TH4R4V3N1324/hexapod-ros2/foxglove_panel/README.md

# Hexapod Foxglove panel

A Foxglove panel for the hexapod, through `foxglove_bridge`:

- **Body**: roll and pitch from `/imu/data`, with an attitude indicator.
- **Feet**: the six feet in their layout, filled when the foot's upward force on
  `/foot_force/legN` is above gait_controller's `contact_force_on`. gait_controller
  publishes these at `foot_force_rate` (20 Hz): at the joint state rate the six
  topics were 600 messages a second, which made Foxglove on the Steam Deck lag.
- **Power**: voltage, current and charge from `/power/left` and `/power/right`, and
  behaviour_manager's battery status from `/diagnostics`. When the battery is low,
  critical (the robot sits down) or a board stops reporting, a banner at the top of
  the panel says so.
- **Mode and gait**: from `get_capabilities`, changed with `set_mode` and `set_gait`.
  Height is sent with `set_height` when the slider is let go (8–15 cm). **Sit down** /
  **Stand up** calls `sit`, and follows `/seated` when behaviour_manager sits the
  robot down on a flat battery.
- **Features**: gait_controller's switchable features. Each shows the node's
  parameter and changes it with its `set_<feature>` service.

## Build and install

Needs Node.js 18 or later.

```sh
npm install
npm run package        # writes raven.hexapod-panel-<version>.foxe
```

Install the `.foxe` by dragging it onto the Foxglove window (or Settings →
Extensions), then add the **Hexapod** panel to a layout. `npm run local-install`
installs it into the Foxglove app on the same machine instead.
