TH4R4V3N1324/hexapod-ros2/steamdeck/images/blink0.png

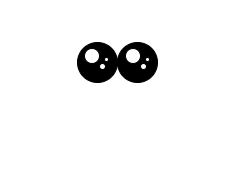
steamdeck/images/blink0.png
