TH4R4V3N1324/hexapod-ros2/hexapod_ws/src/hexapod_description/meshes/body.stl

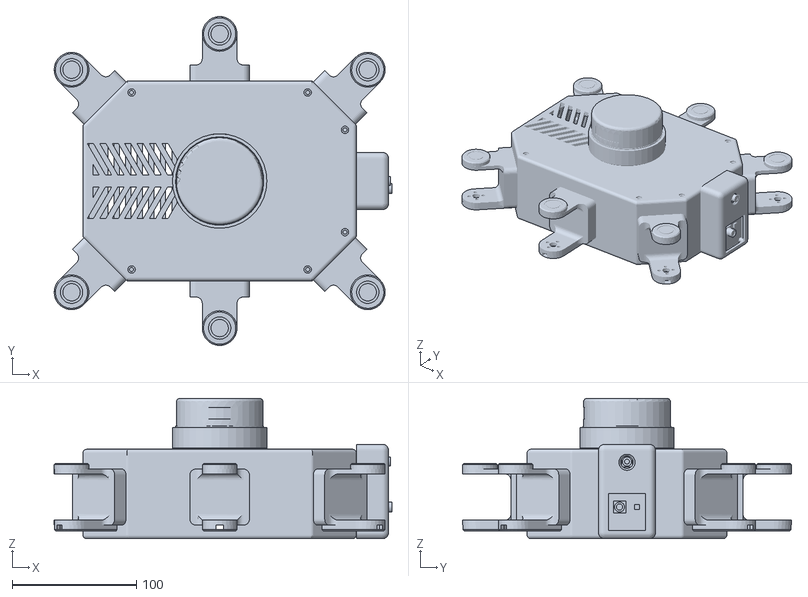
[picture p2: CAD file, 2026-10-23]
hexapod_ws/src/hexapod_description/meshes/body.stl
271.6 x 264.7 x 113.0
