TH4R4V3N1324/hexapod-ros2/hexapod_ws/src/hexapod_description/meshes/femur_right.stl

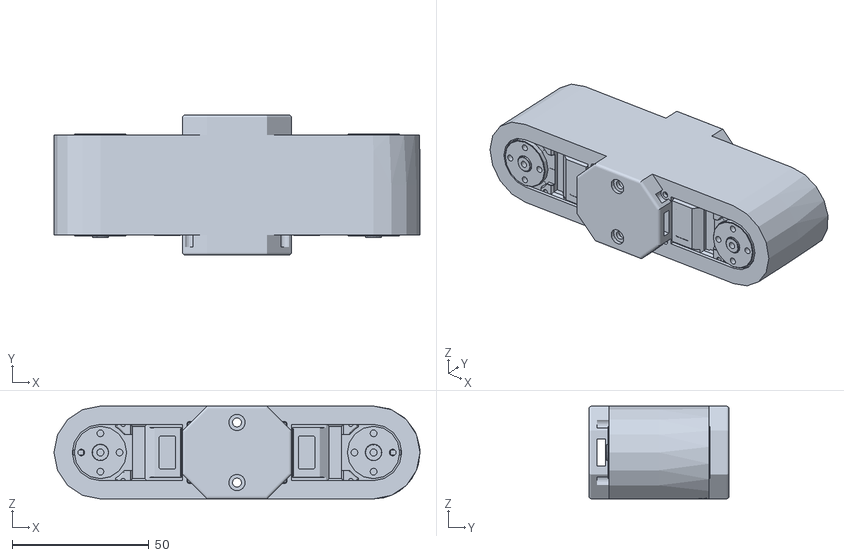
[picture p3: CAD file, 2026-10-19]
hexapod_ws/src/hexapod_description/meshes/femur_right.stl
134.0 x 51.3 x 34.0
