TH4R4V3N1324/hexapod-ros2/hexapod_ws/src/hexapod_gait_controller/test/golden/gait_trace.csv

tick | section | published | leg1_coxa_joint | leg1_femur_joint | leg1_tibia_joint | leg2_coxa_joint | leg2_femur_joint | leg2_tibia_joint | leg3_coxa_joint | leg3_femur_joint | leg3_tibia_joint | leg4_coxa_joint | leg4_femur_joint | leg4_tibia_joint | leg5_coxa_joint | leg5_femur_joint | leg5_tibia_joint | leg6_coxa_joint | leg6_femur_joint | leg6_tibia_joint
0 | startup | 1 | 0 | -0.0579429041008 | 0.0892445608168 | 0 | -0.0579429041008 | 0.0892445608168 | 0 | -0.0579429041008 | 0.0892445608168 | 0 | -0.0579429041008 | 0.0892445608168 | 0 | -0.0579429041008 | 0.0892445608168 | 0 | -0.0579429041008 | 0.0892445608168
1 | startup | 1 | 7.9679209641e-17 | -0.0923363707265 | 0.142341568806 | 0 | -0.0923363707265 | 0.142341568806 | 7.9679209641e-17 | -0.0923363707265 | 0.142341568806 | -7.9679209641e-17 | -0.0923363707265 | 0.142341568806 | 0 | -0.0923363707265 | 0.142341568806 | -7.9679209641e-17 | -0.0923363707265 | 0.142341568806
2 | startup | 1 | 0 | -0.122559213489 | 0.189061395155 | 0 | -0.122559213489 | 0.189061395155 | 0 | -0.122559213489 | 0.189061395155 | 0 | -0.122559213489 | 0.189061395155 | 0 | -0.122559213489 | 0.189061395155 | 0 | -0.122559213489 | 0.189061395155
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
