TH4R4V3N1324/hexapod-ros2/hexapod_ws/src/hexapod_description/urdf/hexapod.urdf.xacro

<robot xmlns:xacro="http://ros.org/wiki/xacro" name="hexapod">

  <xacro:arg name="controllers_file" default=""/>
  <!-- Waveshare ST3215 at 12 V: 2.94 N·m stall torque, 0.222 s/60° no-load speed -->
  <xacro:property name="servo_effort" value="2.94"/>
  <xacro:property name="servo_velocity" value="4.7"/>
  <!-- Femur range from the CAD meshes: raising it hits the coxa bracket at -100 deg, lowering it
       with the knee folded puts the tibia into the body at +86 deg. Both ~10 deg inside contact. -->
  <xacro:property name="femur_lower" value="-1.6"/>
  <xacro:property name="femur_upper" value="1.4"/>
  <!-- Tibia range from the lighter V6.1 tibia (Hexapod_V6_1_posed.step). 0 is the tibia straight out
       in line with the femur (the knee-to-foot line), positive folds it down, so the knee is at 90 deg
       at +90. Folding, the tibia meets the femur's shell at +157 deg; straightening, at -59 deg (both
       within a degree wherever the shank's piston sits). Folding keeps ~6 deg in hand and straightening
       ~14, as before. The gait controller lowers any swing that would fold further (limitSwingLift). -->
  <xacro:property name="tibia_lower" value="-0.78"/>
  <xacro:property name="tibia_upper" value="2.63"/>
  <!-- ros2_control hardware: gazebo, mock or st3215 (see hexapod.ros2_control.xacro) -->
  <xacro:arg name="hardware" default="mock"/>
  <xacro:arg name="serial_port" default="/dev/ttyAMA0"/>

  <!-- ================= CONSTANTS ================= -->
  <!-- Measured from Hexapod_V6.1 (joint caps and feet). base_link sits on the hip plane, the
       height of the femur axes, 33.85 mm above the bottom of the body. -->
  <xacro:property name="coxa_length" value="0.063"/>    <!-- coxa axis to femur axis, level -->
  <xacro:property name="femur_length" value="0.1"/>     <!-- femur axis to knee axis -->
  <!-- Knee axis to the bottom of the foot, along the straight line through the curved tibia
       (171.95 mm to the foot ball's centre, plus its 14 mm radius) -->
  <xacro:property name="tibia_length" value="0.186"/>
  <!-- Coxa axes on the slimmer V6.1 body (220 x 161 mm). Every leg mount's coxa axis is 37.96 mm
       out from the body face it sits on: the middle legs' faces are 80.4 mm from the centre, and
       the corner legs sit in the middle of 45 degree chamfers whose centres are at (92.32, 62.68). -->
  <xacro:property name="middle_leg_y" value="0.11836"/>
  <xacro:property name="corner_leg_x" value="0.11916"/>
  <xacro:property name="corner_leg_y" value="0.08952"/>
  <!-- Meshes are exported from the STEP in mm, already in each link's frame. The tibia's shank sits
       where tibia_length assumes, its foot ball 171.9 mm from the knee. -->
  <xacro:property name="mesh_scale" value="0.001 0.001 0.001"/>

  <!-- Masses and inertias from the CAD (scripts/mass_properties.py) -->
  <xacro:include filename="$(find hexapod_description)/urdf/hexapod.inertials.xacro"/>

  <!-- ================= MATERIALS ================= -->
  <material name="black"><color rgba="0.1 0.1 0.1 1"/></material>
  <material name="red"><color rgba="1 0 0 1"/></material>
  <material name="green"><color rgba="0 1 0 1"/></material>
  <material name="blue"><color rgba="0 0 1 1"/></material>
  <material name="yellow"><color rgba="1 1 0 1"/></material>
  <material name="cyan"><color rgba="0 1 1 1"/></material>
  <material name="magenta"><color rgba="1 0 1 1"/></material>

  <!-- ================= BASE ================= -->
  <link name="base_link">
    <visual>
      <geometry>
        <mesh filename="package://hexapod_description/meshes/body.stl" scale="${mesh_scale}"/>
      </geometry>
      <material name="black"/>
    </visual>
    <collision>
      <geometry>
        <mesh filename="package://hexapod_description/meshes/body.stl" scale="${mesh_scale}"/>
      </geometry>
    </collision>
    <xacro:hexapod_base_inertial/>
  </link>

<!-- ================= LEG LINKS ================= -->
<!-- side: left or right, the left legs being mirror images of the right -->
<xacro:macro name="leg" params="name side x_offset y_offset yaw colour">

  <!-- COXA -->
  <link name="${name}_coxa">
    <visual>
      <geometry>
        <mesh filename="package://hexapod_description/meshes/coxa_${side}.stl" scale="${mesh_scale}"/>
      </geometry>
      <material name="${colour}"/>
    </visual>
    <collision>
      <geometry>
        <mesh filename="package://hexapod_description/meshes/coxa_${side}.stl" scale="${mesh_scale}"/>
      </geometry>
    </collision>
    <xacro:hexapod_leg_inertial link="coxa" side="${side}"/>
  </link>

  <!-- FEMUR -->
  <link name="${name}_femur">
    <visual>
      <geometry>
        <mesh filename="package://hexapod_description/meshes/femur_${side}.stl" scale="${mesh_scale}"/>
      </geometry>
      <material name="${colour}"/>
    </visual>
    <collision>
      <geometry>
        <mesh filename="package://hexapod_description/meshes/femur_${side}.stl" scale="${mesh_scale}"/>
      </geometry>
    </collision>
    <xacro:hexapod_leg_inertial link="femur" side="${side}"/>
  </link>

  <!-- TIBIA -->
  <link name="${name}_tibia">
    <visual>
      <geometry>
        <mesh filename="package://hexapod_description/meshes/tibia_${side}.stl" scale="${mesh_scale}"/>
      </geometry>
      <material name="${colour}"/>
    </visual>
    <collision>
      <geometry>
        <mesh filename="package://hexapod_description/meshes/tibia_${side}.stl" scale="${mesh_scale}"/>
      </geometry>
    </collision>
    <xacro:hexapod_leg_inertial link="tibia" side="${side}"/>
  </link>

  <!-- COXA JOINT -->
  <joint name="${name}_coxa_joint" type="revolute">
    <parent link="base_link"/>
    <child link="${name}_coxa"/>
    <origin xyz="${x_offset} ${y_offset} 0" rpy="0 0 ${yaw}"/>
    <axis xyz="0 0 1"/>
    <limit lower="-1.57" upper="1.57" effort="${servo_effort}" velocity="${servo_velocity}"/>
  </joint>

  <!-- FEMUR JOINT -->
  <joint name="${name}_femur_joint" type="revolute">
    <parent link="${name}_coxa"/>
    <child link="${name}_femur"/>
    <origin xyz="${coxa_length} 0 0" rpy="0 0 0"/>
    <axis xyz="0 1 0"/>
    <limit lower="${femur_lower}" upper="${femur_upper}" effort="${servo_effort}" velocity="${servo_velocity}"/>
  </joint>

  <!-- TIBIA JOINT -->
  <joint name="${name}_tibia_joint" type="revolute">
    <parent link="${name}_femur"/>
    <child link="${name}_tibia"/>
    <origin xyz="${femur_length} 0 0" rpy="0 0 0"/>  <!-- 0: in line with the femur -->
    <axis xyz="0 1 0"/>
    <limit lower="${tibia_lower}" upper="${tibia_upper}" effort="${servo_effort}" velocity="${servo_velocity}"/>
  </joint>

  <!-- COXA TRANSMISSION -->
  <transmission name="${name}_coxa_trans">
    <type>transmission_interface/SimpleTransmission</type>
    <joint name="${name}_coxa_joint">
      <hardwareInterface>PositionJointInterface</hardwareInterface>
    </joint>
    <actuator name="${name}_coxa_motor">
      <hardwareInterface>PositionJointInterface</hardwareInterface>
      <mechanicalReduction>1</mechanicalReduction>
    </actuator>
  </transmission>

  <!-- FEMUR TRANSMISSION -->
  <transmission name="${name}_femur_trans">
    <type>transmission_interface/SimpleTransmission</type>
    <joint name="${name}_femur_joint">
      <hardwareInterface>PositionJointInterface</hardwareInterface>
    </joint>
    <actuator name="${name}_femur_motor">
      <hardwareInterface>PositionJointInterface</hardwareInterface>
      <mechanicalReduction>1</mechanicalReduction>
    </actuator>
  </transmission>

  <!-- TIBIA TRANSMISSION -->
  <transmission name="${name}_tibia_trans">
    <type>transmission_interface/SimpleTransmission</type>
    <joint name="${name}_tibia_joint">
      <hardwareInterface>PositionJointInterface</hardwareInterface>
    </joint>
    <actuator name="${name}_tibia_motor">
      <hardwareInterface>PositionJointInterface</hardwareInterface>
      <mechanicalReduction>1</mechanicalReduction>
    </actuator>
  </transmission>

</xacro:macro>

  <!-- ================= LEGS ================= -->
  <!-- Body frame follows REP 103: +x forward, +y left, +z up -->

  <!-- Front right -->
  <xacro:leg name="leg1" side="right" x_offset="${corner_leg_x}" y_offset="${-corner_leg_y}" yaw="${-pi / 4}" colour="red"/>

  <!-- Middle right -->
  <xacro:leg name="leg2" side="right" x_offset="0" y_offset="${-middle_leg_y}" yaw="${-pi / 2}" colour="green"/>

  <!-- Rear right -->
  <xacro:leg name="leg3" side="right" x_offset="${-corner_leg_x}" y_offset="${-corner_leg_y}" yaw="${-3 * pi / 4}" colour="blue"/>

  <!-- Rear left -->
  <xacro:leg name="leg4" side="left" x_offset="${-corner_leg_x}" y_offset="${corner_leg_y}" yaw="${3 * pi / 4}" colour="yellow"/>

  <!-- Middle left -->
  <xacro:leg name="leg5" side="left" x_offset="0" y_offset="${middle_leg_y}" yaw="${pi / 2}" colour="cyan"/>

  <!-- Front left -->
  <xacro:leg name="leg6" side="left" x_offset="${corner_leg_x}" y_offset="${corner_leg_y}" yaw="${pi / 4}" colour="magenta"/>

  <!-- ================= IMU ================= -->
  <link name="imu_link"/>

  <joint name="imu_joint" type="fixed">
    <parent link="base_link"/>
    <child link="imu_link"/>
    <origin xyz="0.0 0.0 0.03" rpy="0 0 0"/>
  </joint>

  <!-- ================= LIDAR ================= -->
  <xacro:include filename="$(find hexapod_description)/urdf/hexapod.lidar.xacro"/>
  <xacro:hexapod_lidar/>

  <!-- ================= CAMERAS ================= -->
  <xacro:include filename="$(find hexapod_description)/urdf/hexapod.cameras.xacro"/>
  <xacro:hexapod_cameras/>

  <!-- ================= ROS2 CONTROL ================= -->
  <xacro:include filename="$(find hexapod_description)/urdf/hexapod.ros2_control.xacro"/>
  <xacro:hexapod_ros2_control hardware="$(arg hardware)" serial_port="$(arg serial_port)"/>

  <xacro:if value="${'$(arg hardware)' == 'gazebo'}">
    <gazebo>
      <plugin name="gz_ros2_control::GazeboSimROS2ControlPlugin" filename="libgz_ros2_control-system.so">
        <parameters>$(arg controllers_file)</parameters>
      </plugin>
    </gazebo>
  </xacro:if>

</robot>
