TH4R4V3N1324/hexapod-ros2/(commit log)

2026-01-23 Add RViz configuration and update URDF properties for hexapod model
2026-01-23 Update coxa dimensions in hexapod URDF for improved leg geometry
2026-01-23 Fix leg positioning and orientation for rear and front right legs in hexapod URDF
2026-01-23 Add collision geometry for legs and body in hexapod URDF
2026-01-24 Add message definitions for LegContact and PowerStatus in hexapod_interfaces package
2026-01-24 Implement sensor_manager node with publishers for IMU, leg contact, and power status
2026-01-24 Add servo_controller node with joint state publisher and emergency stop service
2026-01-24 Update launch configuration and refine servo controller implementation for joint state handling
2026-01-25 Add service definitions for forward and inverse kinematics, and update dependencies
2026-01-25 Refactor service definitions and implementation for kinematics: update FKSolver and IKSolver request/response types, add kinematic_solver node, and adjust CMake and package dependencies.
2026-01-26 Refactor message definitions: update ControllerRaw, LegContact, and PowerStatus for improved clarity and structure
2026-01-26 Implement EspBridge node with ControllerInput message handling and joint command subscription
2026-01-26 Refactor EspBridge to add IMU, PowerStatus, and LegContact publishers; implement emergency stop service
2026-01-27 Refactor hexapod_hardware_interface: restructure codebase to introduce handler classes for sensor and servo management, remove obsolete fake nodes, and update dependencies
2026-01-27 Refactor hexapod_kinematics: remove obsolete files and integrate kinematic solver into hexapod_gait_controller
2026-01-27 Refactor hexapod_gait_controller: implement kinematic solver and gait controller, update dependencies, and remove obsolete gait_generator
2026-01-27 Refactor kinematic solver: update CMakeLists to include Eigen3, modify kinematic_solver interface for JointAngles struct, and enhance IK/FK methods for improved clarity and functionality
2026-01-27 Add trajectory generator: implement GenStraightTrajectory and GenBezierTrajectory methods, update includes in kinematic_solver and gait_controller
2026-01-27 Add FrameConverter class for leg and body frame transformations; update GaitController to include Eigen
2026-01-28 Refactor launch file: add joint_state_publisher node and update esp_bridge parameters
2026-01-28 Add Gazebo launch file and URDF for hexapod robot simulation
2026-01-28 Update URDF file for hexapod: replace gazebo-specific model with simplified box geometry and add inertial properties; remove obsolete gazebo.urdf.xacro file.
2026-01-30 Add ROS2 control and transmission definitions for hexapod joints in URDF
2026-01-30 Refactor Gazebo launch file: replace ExecuteProcess with IncludeLaunchDescription for improved robot spawning and update URDF processing
2026-01-31 Enhance documentation for inverse and forward kinematics methods in KinematicSolver
2026-01-31 Refactor GaitController: move Gait enum definition and implement getGaitConfig method for leg configuration
2026-01-31 Implement GenerateTrajectories method in TrajectoryGenerator: add functionality for generating swing and stance trajectories with collision checks and body frame conversions
2026-01-31 Refactor TrajectoryGenerator and GaitController: update trajectory generation methods for improved error handling and clarity, replace KinematicSolver with GaitConfig, and enhance frame conversion me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
2026-02-01 Update BlendTargetPosition to use max_stride_length from GaitConfig for stride clamping
2026-02-01 Update frame converter and gait config: change leg translation offsets to meters and update max_stride_length to reflect new unit
2026-02-01 Add trajectory_generator library and update gait_controller for cmd_vel handling
    - Introduced trajectory_generator library with necessary source files.
    - Updated gait_controller to subscribe to cmd_vel and publish joint states.
    - Refactored kinematic_solver methods to follow camelCase naming convention.
    - Adjusted GenBezierTrajectory method signature in trajectory_generator.
2026-02-01 Refactor GaitConfig and GaitController: add rotateZ method, reorganize member variables, and implement returnToStart functionality for improved leg positioning and gait management
2026-02-02 Refactor Normal method for car-like steering: remap lateral movement to angular.z and update documentation
2026-02-03 Refactor GaitController initialization and implement gait timer: enhance command handling and trajectory regeneration logic
2026-02-03 Refactor GaitController to use gaitConfig for current mode in gaitTimerCallback and remove unused currentMode variable
2026-02-03 Refactor leg configuration and kinematics: update leg angles, improve IK/FK methods, and rename joint states for clarity
2026-02-03 Enhance GaitController: add joint state subscription, improve trajectory execution logic, and integrate feedback for leg positions
2026-02-03 Refactor frame conversion methods: implement rotation and translation for leg-to-body and body-to-leg transformations; update ExecuteGait liftHeight parameter to use meters; adjust trajectory collisi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
2026-02-03 Fix Z-axis calculations in kinematic solver and trajectory generator: negate Z in FK to match IK convention and use fixed ground height to prevent Z drift from FK errors.
2026-02-03 Refactor GaitController: remove ExecuteGait method, integrate gait execution logic into Strafe and Normal methods, and enhance trajectory generation with improved leg position handling.
2026-02-03 Refactor GaitController: simplify current leg position retrieval in Strafe and Normal methods to use trajectory endpoints only, eliminating FK feedback to prevent forward drift.
2026-02-03 Refactor GaitController and GaitConfig: streamline leg position handling by adjusting rotation logic and removing unnecessary FK feedback; implement home and startup methods for improved leg initiali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
2026-02-03 Refactor returnToStart method in GaitController: remove unnecessary trajectoryGenerated flag and simplify logic for leg position estimation and phase handling.
2026-02-03 Refactor direction method in TrajectoryGenerator: adjust leg angle calculation for non-mirrored leg configurations to ensure correct transformation from body frame to leg frame.
2026-02-04 Refactor trajectory generation and gait control: introduce SwingSpline structure for improved spline management, enhance target position blending with neutral position references, and implement expon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
2026-02-04 Enhance solveIK method in KinematicSolver: add workspace constraints to ensure target positions are within reach, preventing invalid joint angle calculations.
2026-02-04 Add leg_axis_tester executable: implement a node for testing leg axis movements with joint state publishing and IK solving.
2026-02-04 Refactor KinematicSolver and LegAxisTestNode: simplify IK calculations, improve trajectory generation, and enhance logging for leg axis testing.
2026-02-04 Fix default height in GaitConfig: change currentHeight from 0.15 to -0.15 for correct initialization.
2026-02-04 Fix default currentHeight in GaitConfig: change from -0.15 to -0.12 for accurate initialization.
2026-02-17 Fix tibia transmission name typo in URDF file
2026-03-16 Added meshes to robot URDF
2026-03-17 Refactor URDF Xacro for Hexapod: Remove unused properties and standardize RPY values
    - Removed mesh orientation correction properties: mesh_up_correction_rpy and mesh_up_correction_with_yaw_rpy.
    - Standardized RPY values for base_link, coxa, femur, and tibia links to use fixed values instead of properties.
2026-03-17 Update mesh scaling in URDF: change scale from 0.01 to 1 for body, coxa, femur, and tibia
2026-03-19 Enhance Hexapod control: add joint state relay, update URDF, and configure controllers
2026-04-25 Add joint state relay node to Gazebo launch configuration
2026-04-25 Add sensors to hexapod URDF: camera, front depth camera, IMU, and lidar
2026-04-25 Add launch arguments for front depth camera configuration and improve joint state relay QoS
2026-04-26 Update depth camera parameters and add PCL filtering nodes in simulation
2026-04-27 Remove unused PCL filtering and topic throttling nodes from Gazebo launch configuration; update front depth camera parameters for improved performance.
2026-04-30 Implement stance trajectory retargeting and update GaitState structure for improved leg movement control
2026-05-03 Refactor trajectory generation by simplifying target calculations and removing unnecessary body frame conversions
2026-05-04 Add joint command handling methods for improved leg movement control
2026-05-04 Refactor linearTarget and rotationalTarget methods to simplify inversion and leg mirroring logic
2026-05-04 Fix angular Z axis definition in joyCallback for correct rotation control
2026-05-05 Remove unused velocity parameters and simplify joystick input handling in ControllerTeleop
2026-10-10 Fix X11 display in dev container on WSL
    Mount the X socket from a configurable X11_SOCKET_DIR (set to
    /mnt/wslg/.X11-unix in a git-ignored .env on WSL), drop the unused
    .Xauthority mount, and default DISPLAY to :0.
2026-10-10 Replace Servo2040 backend with ST3215 ros2_control and I2C sensor drivers
    The Pi 5 now drives Waveshare ST3215 bus servos directly, and reads the
    BMI088 IMU and the two INA226 power monitors over I2C.
    - Add ST3215System, a ros2_control plugin that sync-writes goal positions
    and sync-reads position, speed and load (published as joint effort)
    - Add bmi088_node (sensor_msgs/Imu on imu/data_raw, fused to imu/data by
    imu_filter_madgwick) and ina226_node (sensor_msgs/BatteryState on
    power/left and power/right)
    - Share one ros2_control xacro between gazebo, mock and st3215 hardware;
    servo IDs are leg * 10 + joint
    - Add hexapod_robot.launch.py; hexapod_fake.launch.py now runs it on
    ros2_c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
2026-10-10 Use joint state feedback for leg positions and fix forward kinematics
    solveFK was not the inverse of solveIK (wrong femur sign and inverted Z),
    so the fk_solver service returned wrong positions. It now round-trips
    exactly.
    The gait controller matches /joint_states by joint name and computes
    each foot's measured position with FK. Startup waits for joint states
    and moves the legs from their measured positions to the start pose,
    instead of commanding an instant jump to home.
2026-10-10 Make gait timing time-based instead of tick-based
    Each tick now advances the gait by the measured time since the last tick
    divided by the phase duration, so the loop rate no longer changes how
    fast the robot walks.
    - Add parameters for loop_rate, phase_duration, max_foot_speed,
    idle_return_delay and startup_duration, defaulting to the old timings
    - Add max_joint_speed: a tick's progress is scaled down if any joint
    would move faster than this, keeping all legs in phase
    - Use a ROS timer and set use_sim_time in the simulation launch so the
    gait follows Gazebo's clock
2026-10-10 Make /cmd_vel real m/s and scale the gamepad to the true top speed
    The tripod gait walked at 0.6x the commanded speed and ripple/wave had no
    fixed relationship, while get_capabilities reported a 0.2 m/s maximum
    the robot never reached.
    - Plan each phase from the commanded velocity: stance feet move back at
    body speed, swing feet land ahead of neutral by half the stroke
    - Shorten phases once the stride hits MAX_STRIDE_LENGTH, down to a new
    min_phase_duration (0.7 s), and cap commands at the gait's top speed
    - Report the current gait's real top speeds from get_capabilities
    - controller_teleop scales the sticks by those speeds and fetches them
    asynchronously instead of blocking at startu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
2026-10-10 Add rubber foot spheres and an obstacle-free test world to the sim
    - Tibias end in a 12 mm sphere with mu 1.5, its bottom at the IK leg
    length, instead of contacting with the cylinder rim
    - Add empty_world.sdf (ground mu 1.5) and a world launch argument;
    hexapod_world stays the default
    - Gazebo runs DART by default, which takes the lower mu of the two
    surfaces and ignores Bullet friction values
2026-10-10 Turn about the body centre, run the gait at 100 Hz, and add direction tests
    - Rotate each foot about the body centre for yaw, using leg frames that
    match the URDF coxa yaws; turning in Gazebo went from 59% to 76% of
    the commanded rate
    - Default loop_rate to 100 Hz to match the controller manager; smaller
    steps between targets improved forward speed from ~79% to ~86%
    - Add gtest unit tests for foot displacement directions and arc length
    - Add sim_direction_check.py, which drives each direction in Gazebo and
    checks the robot moves the right way in its own frame
2026-10-10 Switch the body frame to REP 103 (+x forward, +y left)
    The URDF had +y forward and +x right, which tools like Nav2 and
    robot_localization would misread.
    - Rotate the body frame -90° in both URDFs: leg offsets, coxa yaws,
    camera mounts and body box rotated with it; leg frames are unchanged,
    so IK and joint angles are unaffected
    - Correct the leg comments: legs 1-3 are right (front, middle, rear),
    4-6 left (rear, middle, front)
    - FrameConverter stores each leg's URDF yaw and offset instead of a
    mounting angle plus a mirrored flag that didn't match legs 4-6
    - MotionIntent uses left (= linear.y) instead of lateral, removing the
    sign flip in strafe mode
    - Update unit tests, the sim di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
2026-10-10 Bind-mount /dev/input so controllers attached after start appear
    A devices mapping only copies the input nodes that exist when the
    container starts, so a controller passed through to WSL later never
    showed up inside the container.
2026-10-10 Add leg odometry fused with the IMU gyro through robot_localization
    - gait_controller estimates body motion from the planted feet (FK of
    measured joints, rigid 2D fit) and publishes odometry/legs at 50 Hz
    - robot_localization EKF fuses leg velocity with the IMU yaw rate and
    publishes odometry/filtered and the odom -> base_link transform; added
    to the robot and simulation launches and the Dockerfile
    - Unit tests for the motion fit and pose integration
    - Load the IMU and magnetometer systems in both worlds; the simulated
    IMU never published without them
    - Run the simulated IMU at 1000 Hz: at 100 Hz its instantaneous samples
    under-read turns by ~9% because the body's yaw rate jerks ea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
2026-10-10 Add RPLIDAR A2M12 support and match the simulated lidar to it
    - Run Slamtec's rplidar_ros driver with the other sensors on the real
    robot (256000 baud, lidar_link, published on /lidar/scan like the sim)
    - Add a udev rule naming the lidar /dev/rplidar, and bind-mount the Pi's
    /dev into the robot container so the symlink and hot-plugged devices
    are visible
    - Share the lidar mount between the real and Gazebo URDFs in
    hexapod.lidar.xacro, so one lidar_z change moves both
    - Simulated lidar now matches the A2M12: 10 Hz, 1600 points (0.225 deg),
    0.2-12 m
2026-10-10 Add slam_toolbox mapping and raise the lidar above the legs
    - slam:=true on the simulation and robot launches runs slam_toolbox
    (online async), publishing map -> odom; config based on the package
    defaults, adding scans every 0.2 m / 0.2 rad and using the A2M12 range
    - Raise the lidar scan plane from 5 cm to 15 cm above the hip joints. At
    5 cm, 20% of each scan hit the robot's own legs; the knees reach ~12 cm
    (with leg thickness) at the end of a stride
    - In the house world, after a 0.6 m square, SLAM was 1.8 cm and 0.2 deg
    from the true pose (odometry alone: 15.5 cm)
2026-10-10 Add Nav2 navigation on the SLAM map
    - nav:=true on the simulation and robot launches runs Nav2 with
    nav2_params.yaml: 0.32 m footprint radius, 0.45 m inflation, MPPI and
    velocity smoother capped under the gait's limits, recovery spins too
    - Normal mode now also turns from angular.z, which Nav2 sends; the
    gamepad's linear.y turning is unchanged
    - Leave MPPI acceleration limits at Nav2's defaults: it starts each cycle
    from the measured speed and the gait responds slowly, so low limits
    stopped it ever speeding up
    - Fix transform timing: the EKF stamps output at the current time, and
    slam_toolbox stamps map -> odom 1 s ahead (more than its 0.5 s scan
    interval), so Nav2 stops failin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
2026-10-10 Apply commands every tick without leg collisions, and let Nav2 strafe
    The gait only read /cmd_vel at the start of each phase, so a reversal took
    ~1.9 s to show. Commands now apply every tick:
    - Stance feet move with the current body velocity; swing feet re-aim their
    landing target (up to max_target_speed) and fly from their lift-off point
    - Every foot stays within MAX_STRIDE_LENGTH of neutral and both ends of a
    swing are inside that circle, so neighbouring legs keep at least ~2.5 cm
    between segments; test_leg_clearance checks it for every adjacent pair
    - Reversal now shows in the body's motion within 0.06 s
    Nav2 now uses strafe mode: with nav:=true the gait starts in strafe mode
    (new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
2026-10-10 Add LaserScan and PointCloud2 displays to the RViz config
2026-10-10 Use the ToF depth camera for low obstacles, add base_footprint, face forwards
    Cameras:
    - Add hexapod.cameras.xacro, shared by the real and Gazebo models: the
    Arducam ToF camera (B0410) below the Pi Camera Module 3, front facing,
    ToF tilted 10 deg down. The simulated sensors match them (ToF 240x180,
    58.5 deg HFOV, 4 m far mode; Cam 3 standard lens, 66 deg)
    Floor frame:
    - gait_controller publishes base_footprint -> base_link (the body height,
    republished on set_height); odometry, SLAM and Nav2 use base_footprint,
    so z = 0 in odom is the floor
    Nav2:
    - Both costmaps take the depth cloud (3-35 cm above the floor, ignoring
    points within 0.3 m of the camera) as 3D voxel layers, so the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
2026-10-10 Include IMU roll and pitch in base_footprint -> base_link
    The body rocks by up to ~0.8 deg while walking, but base_footprint ->
    base_link was a level offset, so the depth camera's view of floor 3.5 m
    away landed up to 5 cm too high and was marked as obstacles, leaving
    phantom patches across the global costmap.
    gait_controller now publishes the transform every tick with the body
    height plus roll and pitch from imu/data. In the low_obstacles world,
    phantom cells after an out-and-back went from 127 (0.32 m^2) to 0.
2026-10-10 Add tilt mode with IMU body leveling and a moving-platform world
    Tilt mode keeps the feet planted and moves the body to the pose on
    /body_pose (geometry_msgs/Pose). The IMU holds roll and pitch in space
    while the ground tilts. Pose changes are rate limited per tick, and
    poses the legs can't reach safely are cut back, yaw first. The gamepad
    teleop drives /body_pose and cycles modes and gaits. GetCapabilities
    reports the tilt limits and the current mode and gait. The
    tilt_platform world has a motorised deck for testing.
2026-10-10 Level the body while walking, and remove config mode
    In normal and strafe mode, the IMU builds up a roll/pitch correction
    (walk_leveling, on by default) that keeps the body level on slopes. It
    rotates about the ground point under the body, and is capped and cut
    back to what the legs can reach. The gait still works in the level
    frame, and leg odometry has the tilt removed. Tilt mode takes over the
    levelled pose on entry and hands it back on exit.
    Config mode is removed, since the bus servos don't need it, and
    set_mode now rejects invalid modes.
2026-10-10 Sense foot contact from joint effort, balance leg loads, fix odometry
    The gait controller turns each leg's joint efforts into the ground
    force on its foot and publishes it on foot_force/legN
    (geometry_msgs/WrenchStamped). Each leg learns its zero reading
    mid-swing, and contact uses hysteresis. Load balancing raises or
    lowers planted feet so the weight is shared, keeping body height and
    tilt unchanged.
    Odometry fixes:
    - Only loaded feet count.
    - Translation is dropped while the feet push against an obstacle.
    - Joint states with a repeated timestamp are skipped instead of losing
    their motion, which made odometry read about 20% short in simulation.
    Feet left a few mm up after stopping are n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
2026-10-11 Adapt the gait to uneven ground with foot forces and a depth height map
    Each foot remembers its ground height, stays on it in stance and aims
    for it on its next swing.
    Foot forces:
    - A swing that lands over 1 cm above its target, pushing up for 3
    ticks, stops there.
    - A foot still unloaded 0.15 s after its swing reaches down for the
    ground.
    - A sideways hit mid-swing lifts the foot higher.
    Depth camera:
    - Points build a 2 cm height map in odom, published on terrain_map.
    - Each swing takes its landing height from the map, moves off edges and
    lifts to clear what is in its path.
    - The robot's own feet are filtered out, frames are processed sparingly
    so gait ticks aren't delayed, and o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
2026-10-11 Add SetBool services to switch gait controller features on and off
    set_terrain_adaptation, set_terrain_map, set_walk_leveling,
    set_tilt_leveling, set_tilt_lock_yaw and set_load_balancing each set
    the parameter of the same name, so services and ros2 param agree and
    the change applies straight away.
2026-10-11 Toggle gait controller features from the gamepad face buttons
    A, B, X and Y switch terrain adaptation, walk leveling, load balancing
    and tilt leveling on and off. Each press reads the feature's current
    state from the gait controller and calls its set_<feature> service with
    the opposite value, so a change made another way is never undone.
    Button numbers are parameters.
2026-10-11 Map the gamepad to the SDL game controller layout joy_node reports
    ROS 2's joy_node reports the standard game controller layout (right
    stick on axes 2 and 3, triggers on 4 and 5). The old defaults followed
    the raw Xbox order, so pitch was on a trigger and the robot tilted as
    soon as tilt mode started. Turning, the d-pad (now buttons 11 and 12)
    and the mode and gait buttons were also wrong.
    Each trigger's first reading is taken as released, since drivers report
    0, 1 or -1. The operator launch uses device_id instead of the ROS 1 dev
    parameter.
2026-10-11 Replace the BMI088 IMU with the ISM330DHCX
    The ISM330DHCX is easier to buy. The new node publishes the same
    sensor_msgs/Imu on imu/data_raw, so the Madgwick filter, EKF and
    simulation are unchanged. It also accepts the older ISM330DLC, which
    Adafruit sold on the same style of board.
2026-10-11 Add outdoor test worlds and a scenario runner
    Three generated worlds approximate outdoor ground: hills and side
    slopes, a seeded rock field, and lanes from dry ground down to wet
    tile. scenario_runner.py walks the robot through 16 scenarios across
    them, each in a fresh simulation, and scores the run against Gazebo's
    true pose: progress, sideways drift, odometry error, body tilt and
    falls.
    The simulation launch gains gui, rviz and spawn_x/y/z/yaw arguments,
    and the robot model publishes its true pose on /ground_truth/odom.
2026-10-11 Count foot events in the scenario runner
    The runner now starts gait_controller at debug log level and counts
    early touchdowns, ground searches and stumbles during each walk, to
    measure false landings. It can turn gait features off for a whole run
    (--disable terrain_map), takes comma-separated --only names, and adds
    a slabs scenario on the rough_terrain world.
2026-10-11 Stop false stumbles and turn the terrain map off by default
    A stumble now needs the foot pushed sideways without bearing weight
    for 3 ticks. Normal landings, which push back and up at once, and the
    filtered push-off just after lift-off both counted as stumbles: about
    38 on a 2 m walk over flat ground, each popping the foot up as it
    landed. Flat ground now gives none; slabs, rocks and hills still give
    7-15 a run.
    The depth camera height map is off by default. In the outdoor
    scenarios it caused more early touchdowns and stumbles than the feet
    alone and walked worse on hills (1.62 m against 2.29 m over the 15
    degree hill). Force-based terrain adaptation stays on.
2026-10-11 Set up the robot Pi: I2C, hotspot and start at boot
    pi/setup_pi.sh configures a fresh Raspberry Pi OS install: I2C at
    400 kHz, the servo UART, the lidar udev rule and the hostname (in
    cloud-init too, which otherwise renames it at boot). It adds a
    "hexapod" Wi-Fi hotspot at 192.168.50.1 on a second interface (uap0)
    while wlan0 stays on the home Wi-Fi for internet; home Wi-Fi is kept to
    2.4 GHz so the hotspot can share its channel. hexapod-start.service
    pulls the latest code at boot, rebuilds with --pull and runs
    docker compose up.
    The Steam Deck script tries the hotspot address before scanning.
2026-10-11 Add a Hexapod Foxglove panel
    foxglove_panel/ is a Foxglove extension with a Hexapod panel: body roll
    and pitch from the IMU, foot contact and force for each leg, power for
    each side, mode, gait and body height, and switches for gait_controller's
    features, each showing the node's parameter and calling its set_<feature>
    service. The Steam Deck setup builds and installs it into Foxglove.
2026-10-11 Cap the Steam Deck's /joy at 50 Hz
    The Deck's sticks jitter just off centre, and game_controller_node
    publishes every change by default (up to 1 kHz). About 400 /joy messages
    a second queued up over Wi-Fi and the robot reacted about a second late.
    coalesce_interval_ms:=20 merges them to at most 50 Hz.
2026-10-11 Glide to a new body height instead of jumping
    set_height changed the foot targets at once, and standing still only the
    planted half of the legs followed: the other half sit at the start of a
    swing that never advances, and re-took their old position every tick.
    They then jumped to the new height on the first step. The body now moves
    at height_rate (0.03 m/s), shifting every foot by the same amount each
    tick, including swinging feet, their last commanded positions and tilt
    mode's ground points. Heights outside min_height-max_height (0.06-0.16 m)
    are refused.
    In simulation the body lowers from 12 to 8 cm in 1.3 s with all six legs
    moving together, walks steadily at 8 cm, and rises smoothly mid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
2026-10-11 Keep the Pi's hotspot from disappearing at boot
    Setting the home Wi-Fi to 2.4 GHz made NetworkManager rewrite its
    netplan file with "match: {}", so at boot it could try the connection
    on uap0, which the driver then removed: no hotspot, and no /joy from
    the Steam Deck. The home connection is now bound to wlan0 by MAC
    address (netplan drops an interface name) and retries forever instead
    of giving up after 4 tries. The dispatcher script also recreates uap0
    and the hotspot if it has gone when wlan0 comes up, and system logs are
    kept across reboots so boot problems can be diagnosed.
2026-10-11 Publish foot forces at 20 Hz
    foot_force/legN were published on every joint state update: 600
    messages a second across the six legs on the robot. They are only for
    display (the controller uses every update itself), and once the Hexapod
    Foxglove panel subscribed to them, Foxglove on the Steam Deck lagged
    behind the robot. foot_force_rate (20 Hz) limits them to 120 a second.
2026-10-12 Mount the lidar on the lid and filter out the robot's legs
    On the V6.1 body the RPLIDAR sits on the lid, centred, with its scan
    plane 73.5 mm above the hip joints instead of on a 15 cm mast, so the
    legs cross the scan plane. A laser_filters chain drops returns nearer
    than 0.30 m (inside the legs' reach) as NaN and publishes
    /lidar/scan_filtered, which SLAM and Nav2 now use. It runs in both the
    robot and simulation launches.
    In simulation the legs take none of the scan standing, 3% walking (10.5%
    at worst) and 5.7% walking with the body at 8 cm; none leak through the
    filter, and slam_toolbox maps normally.
2026-10-15 Move the IMU and power monitor drivers out of their nodes
    The ISM330DHCX and INA226 register handling lived inside
    ism330dhcx_node and ina226_node, so nothing else could talk to the
    chips. It is now in Ism330dhcx and Ina226 classes, built with
    I2CDevice into an i2c_sensors library. The nodes just call them, and
    the IMU node publishes exactly what it did before. Ina226 can also
    read the chip's die ID.
    ST3215Bus gains readRegisters and writeRegisters for any block of
    registers on one servo (a write can also go to every servo at once),
    plus the addresses for ID, angle limits, EEPROM lock, voltage,
    temperature and moving.
2026-10-15 Add standalone test programs for each piece of hardware
    hardware_tests/ has a program per device for bringing up the real
    robot without the full stack: test_servos (scan, monitor, move, wiggle
    and set IDs on the ST3215 bus), test_power (both INA226s), test_imu
    (ISM330DHCX) and test_lidar (RPLIDAR) build and install with the
    package, so they run in the container with ros2 run. test_camera.sh
    (Camera Module 3) and test_tof.py (Arducam ToF, via Arducam's SDK) run
    on the Pi itself, outside the container, because they need Raspberry Pi
    OS's libcamera. hardware_tests/README.md explains each one and suggests
    a bring-up order.
    None of them has been run on the real hardware yet.
2026-10-15 Record raw video in the camera test
    The Pi 5 has no H.264 hardware encoder and rpicam-apps-lite has no
    software one, so rpicam-vid's default codec recorded nothing. Show
    rpicam-vid's error output when no frames are recorded.
2026-10-16 Match the URDF and kinematics to the V6.1 design
    Dimensions measured from Hexapod_V6.1_stand.step and checked against
    the walk pose: coxa 63 mm, femur 100 mm, and the curved tibia's
    straight line from knee to the bottom of the foot 186 mm. The coxa
    axes are 148 mm from the centre with the corner legs at 45 degrees,
    and the femur axes are level with the hips. The solver and the URDF
    had different lengths before; both now use these.
    New STL meshes are exported from the STEP in each link's frame, with
    left and right legs (mirror images) separate, leaving out parts hidden
    inside the body and the servos. The Gazebo model uses them as visuals
    while keeping simple collision shapes. The lidar and c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
2026-10-17 Widen the femur's range to what the V6.1 CAD allows
    The +-1.57 rad joint limits came from the old 180 degree servos; the
    ST3215s turn a full circle, so the limits now come from where the
    meshes collide. Sweeping the femur against the CAD meshes, raising it
    hits the coxa bracket at -100 degrees, and lowering it with the knee
    folded puts the tibia into the body at +86 degrees. The femur's limits
    are now -1.6 to +1.4 rad (about 10 degrees inside contact) in both
    URDFs, and reachable() uses the same range instead of +-1.4.
    The coxa and tibia are unchanged. The tibia's bracket hits the femur's
    knee servo at a +28 degree fold in the CAD, inside what the gait uses
    (+22 standing, up to +77 mid-step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
2026-10-17 Add a sit service to the gait controller
    sit (std_srvs/SetBool) rests the body on the ground so the servos
    carry almost nothing: true sits, false stands. At the standing reach
    the femurs can't lift far enough to lower the body, so the feet first
    step out to sit_reach (0.26 m) a gait group at a time, reusing
    returnToStart with widened start positions, then the body lowers to
    sit_height (feet 1.5 cm below the hips; the body's underside is 3.4 cm
    below them, so it lands first). Standing up is the reverse, and a
    request part way through reverses from wherever the move has got to.
    While sitting, /cmd_vel, set_height and tilt mode are refused or
    ignored, and load balancing and walk leveling unwin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
2026-10-17 Add a behaviour manager that sits the robot down on a flat battery
    hexapod_control's behaviour_manager watches the daughter boards' power
    monitors (power/left and power/right), filtering each board's voltage
    over 5 s so the dips while walking don't trip it, and uses the lower
    board. Below 10.5 V (3.5 V/cell) it warns and buzzes the controller on
    joy/set_feedback; below 9.9 V (3.3 V/cell) it calls the gait
    controller's sit service once. A level clears 0.2 V above its
    threshold. It never stands the robot back up: standing it up while
    critical is the operator's override. Without readings the level holds.
    The state goes out on /diagnostics. Thresholds are in
    hexapod_bringup/config/behaviour_mana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
2026-10-17 Show battery warnings and a sit toggle in the Hexapod panel
    The panel reads behaviour_manager's battery entry on /diagnostics. The
    Power section leads with the battery status and the filtered voltage,
    and when the battery is low, critical or a board stops reporting, a
    banner at the top of the panel says so (amber, or red at critical).
    A Sit down / Stand up button in the Mode and gait section calls
    gait_controller's sit service, and follows /seated, so it turns to
    Stand up once behaviour_manager has sat the robot down on a flat
    battery.
2026-10-18 Limit the knee to the revised V6.1 tibia and keep swings inside it
    Sweeping the revised knee in Hexapod_V6.1.step against its meshes,
    folding the tibia meets the femur at +60 degrees (39 mm from the knee
    axis, so the same whether the shank's piston is in or out), and
    straightening at -140. The tibia's limits are now -2.2 to +0.94 rad in
    both URDFs and in reachable().
    In Gazebo the gait asked for more than that: strafing's middle-leg
    swings reach nearly full lift while the foot is still ~40 mm inside
    neutral, folding the knee to +55 degrees, and strafing diagonally while
    turning once asked for +72 at the knee and -100 at the femur, past the
    CAD's contact at both. limitSwingLift() lowers a sw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
2026-10-18 Add an NVIDIA compose override so Gazebo can render on the server's GPU
    The dev container sees the card through privileged mode but only has Mesa,
    so Gazebo's sensor rendering failed EGL setup and segfaulted.
2026-10-18 Rumble the battery warnings at full strength in a train of pulses
    The joy node plays each rumble for a fixed second, so one half-strength buzz
    was easy to miss. Low now plays 2 full-strength pulses and critical 4, with
    the intensity, counts and spacing as parameters.
2026-10-19 Widen the knee's range to the lighter V6.1 tibia and update its meshes
    Sweeping the new tibia (Hexapod_V6_1_posed.step) against the femur, the
    tibia shell meets the femur's at +67.6 degrees folding and -149.8
    straightening, both about 100 mm from the knee axis and within a degree
    wherever the shank's piston sits; the RM leg agrees. Keeping the old
    margins (~6 degrees folding, ~14 straightening), the knee's limits go
    from -2.2..+0.94 to -2.35..+1.06 rad in both URDFs and in reachable().
    The femur's contacts are unchanged, so its limits stay.
    The femur and tibia meshes are re-exported in the same link frames and
    detail as before (re-exporting the Oct 16 CAD this way reproduces the
    old STLs to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
2026-10-23 Give the URDF real masses and inertias from the V6.1 CAD
    Every link had a placeholder inertial: a 1 kg body with 0.1 kg m^2
    of inertia and 50-100 g legs, so the simulated robot weighed about
    2.2 kg with link inertias 10-1000 times too big. The new
    scripts/mass_properties.py reads Hexapod_V6.1.step (the body and one
    leg), puts each solid in the link it moves with, and writes
    urdf/hexapod.inertials.xacro, which both URDFs now use.
    Bought parts get their real weight spread over their CAD volume
    (ST3215 55 g, Pi 5 46 g, RPLIDAR A2M12 190 g; the battery, boards and
    cameras are estimates). Printed parts are the filament's density
    (PA12-CF legs, PETG body, TPU feet) at 60% of solid for walls and
    i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
2026-10-23 Move the legs to the slimmer V6.1 body
    Hexapod_V6.1.step now has a 220 x 161 mm body. The middle legs' mounts
    sit on side faces 80.4 mm from the centre, so their coxa axes are
    118.36 mm out instead of 148. The corner legs stay at 45 degrees but
    sit in the middle of chamfers centred at (92.32, 62.68) mm, which puts
    their coxa axes at (119.16, 89.52) mm. Both URDFs and the gait
    controller's FrameConverter use the new positions.
    body.stl is re-exported from the new STEP in base_link (the body and
    lid shells, lidar, camera pod and six leg mounts), and the primitive
    model's body collision becomes a 220 x 161 mm box. The base inertial
    is regenerated with the leg mounts in their new places.
    The f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
2026-10-25 Ease the swings half as much so the gait doesn't pause at each phase change
    evalBezier timed every swing with smootherstep, which starts and ends it
    at rest. With the path already rising almost straight up, the landing
    and lifting feet were both nearly still around each phase change, and in
    Gazebo the body slowed to 0.43-0.59x its mean speed there.
    A new swing_easing parameter blends smootherstep with even progress
    (0 even, 1 the old easing), defaulting to 0.5; the path is unchanged. At
    half speed the slowest point is now 0.88x the mean, at full speed 0.83x
    (was 0.65x), and the body averages 9% faster at full command. Feet land
    at about half the even-pace speed (~0.17 m/s at full command);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
2026-11-02 Track the body's height with the leg odometry so the depth map follows climbing
    The depth camera's points go into the height map through TF, which keeps
    base_footprint at z = 0, plus ground_level. With terrain adaptation off,
    as when a policy drives the gait, ground_level stays 0, so every cell was
    stored as if the body had never left the floor it started on. Read back
    relative to the body, a cell was off by however far the body had climbed
    since it was seen: up to 12-14 cm on Gazebo's 4 cm stairs and 10 deg hill.
    The leg odometry now also measures how far the planted feet move up or
    down relative to the body, levelled by the IMU's roll and pitch as the
    footprint TF is, and integrates that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
2026-11-02 Tilt the ToF camera 30 deg down to match the pod
    Facing straight ahead the camera first saw the ground 0.45 m ahead of the
    body, past the front feet, and half its view was above the horizon.
    Tilted 30 deg down, as the revised pod and the training sim have it, it
    sees from the front feet to ~1.1 m.
    In Gazebo with terrain adaptation off, map cells near the body read
    relative to it got closer to the true terrain on all three test lanes:
    median / 95th percentile error on 4 cm stairs 6.0 / 42 to 5.7 / 36 mm,
    on a 10 deg hill 7.3 / 20 to 5.0 / 16.5 mm, and on 0-4 cm boxes
    8.6 / 43 to 6.9 / 32.5 mm (one run each).
2026-11-04 Start up seated, and stand only when asked to on the robot
    Startup moved every leg in a straight line from wherever it was straight
    to the standing pose. It now goes to the seated pose (feet out at
    sit_reach, body resting on the ground) and ends seated, and the stand up
    from there is the same as after a sit request. The new stand_on_startup
    parameter (default false) stands it up straight away; otherwise it waits
    for a sit request of false, such as the Foxglove panel's Stand up button,
    so the robot doesn't get up by itself at power-on. The simulation launch
    sets it, so the sim is ready to drive.
    /seated is now true whenever the robot isn't standing ready to walk,
    including while it sits down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
2026-11-04 Make the tibia's zero straight out in line with the femur
    Tibia = 0 had the knee at 90 deg, which is hard to set exactly when
    centring a servo. It is now the tibia straight out in line with the femur
    (along the knee-to-foot line), so with every joint at 0 a leg lies out
    flat and each servo can be centred in that pose, leaving its offset at 0.
    Positive still folds the tibia down: the old 90 deg knee is now +90 deg
    and standing is about +111 deg.
    The IK returns pi - q3 rather than pi/2 - q3 and the FK drops the
    pi/2. Both URDFs' tibia joints now have a zero origin rotation, so the
    tibia link sits in the same place at the same physical pose and its mesh
    and inertia are unchanged, and the tibia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
2026-11-04 Add calibration and the rest of the servo tools to test_servos
    test_servos could scan, monitor, move, wiggle, go limp and set IDs, but
    not calibrate. It now also has:
    - centre <id>: torque off, move the joint by hand to the pose that should
    read 0, press Enter, and the servo stores that as its centre
    - offset <id> [steps]: show or fine-tune the stored offset
    - limits <id> min|max [degrees]: set one angle limit at a time, typed or
    recorded by hand; limits <id> <min> <max>, limits <id> clear, and
    limits <id> to show them. Separate from centre, which warns that
    limits set before it have moved with it, and move warns when a goal is
    outside them
    - ports, ping, info (every register, dec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
2026-11-04 Add test_leg to drive one leg with the IK, and drop leg_axis_tester
    test_servos works one servo at a time, and leg_axis_tester moved all six
    legs through /joint_commands, so it needed the ros2_control stack running
    without the gait controller, started from a stale foot-at-hip-height
    pose, looped forever and never checked where the feet went.
    test_leg drives one leg's foot with the gait controller's IK, straight on
    the servo bus like test_servos, using each joint's direction and offset
    from hexapod.ros2_control.xacro. Its commands:
    - where and monitor: the foot position (forward kinematics of the joints)
    and joint angles, once or live. Moving a limp leg by hand under monitor
    shows any j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
2026-11-04 Turn every tibia servo the other way to its joint
    On the robot, test_leg stand drove leg 1's tibia up past straight until
    it hit the femur's shell (about -55 deg) instead of folding it down to
    +111.5 deg, and the folded rest pose read -152 deg where it should read
    about +150: the tibia servos are mounted to turn the opposite way to the
    joint.
    The leg macro in hexapod.ros2_control.xacro now takes coxa_direction,
    femur_direction and tibia_direction (default 1), and every leg sets
    tibia_direction -1. The legs are identical and the URDF only turns each
    about the body, so it's the same on all six. test_leg and the
    ST3215System driver both read these.
2026-11-10 Enhance servo testing utility with calibration and interactive shell
    - Added calibration functionality to record joint travel and set limits.
    - Introduced interactive shell mode for easier command execution.
    - Implemented new commands for centering servos and managing limits.
    - Improved user prompts and help documentation for clarity.
    - Refactored main command execution logic to support new features.
2026-11-13 Use hexapod-gait-core as a submodule for the gait maths
    The kinematics, frames, trajectories and leg odometry now come from
    hexapod-gait-core, checked out at hexapod_ws/src/hexapod-gait-core and
    built by colcon as the gait_core package. hexapod_gait_controller keeps
    only the ROS node and the height map, and links gait_core::gait_core.
    The core uses float by default, so colcon.meta builds it with
    GAIT_CORE_USE_DOUBLE=ON. gait_controller fails to compile if it isn't
    built that way. The Dockerfile and dev compose file pick up colcon.meta.
    The controller's copies of the gait maths tests are removed. The same
    tests live in the core repository and pass with double.
    test_leg in hexapod_hardware_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
2026-11-13 Pin hexapod-gait-core to v0.1.0
2026-11-13 Refactor gait controller structure and add golden trace testing framework
2026-11-13 Run the gait on gait_core::GaitEngine
    gait_controller is now a ROS wrapper: parameters fill GaitParams,
    topics and services feed the engine, and its joint targets, odometry
    and foot forces are published. The height map stays here and plans
    footholds through the engine's FootholdPlanner hook. The golden trace
    matches the previous controller on every tick.
    Pins hexapod-gait-core to v0.2.0.
2026-11-13 Pin hexapod-gait-core to v0.3.0
2026-11-13 Pin hexapod-gait-core to v0.4.0; run the battery behaviour on gait_core::behaviour
2026-11-13 Pin hexapod-gait-core to v0.5.0: battery behaviour and servo power (SERVO_EN)
2026-11-14 Enhance teleoperation: add body height control and power management via gamepad; update capabilities service
2026-11-14 Update hexapod-gait-core to v0.6.0; run the shared gamepad layout
    controller_teleop now uses gait-core's hexapod_teleop::GamepadTeleop,
    the same layout code as hexapod-controller's gamepad receiver, so a
    gamepad drives every stack the same way. The node keeps the ROS side:
    joy axis and button parameters, trigger calibration, services and
    capabilities. It also runs the layout every 50 ms, so the RB hold and
    the D-pad repeat are timed without joy's autorepeat. Parameters, topics
    and services are unchanged.
